cvy7/s_controller/hw/ev69_1_1.png

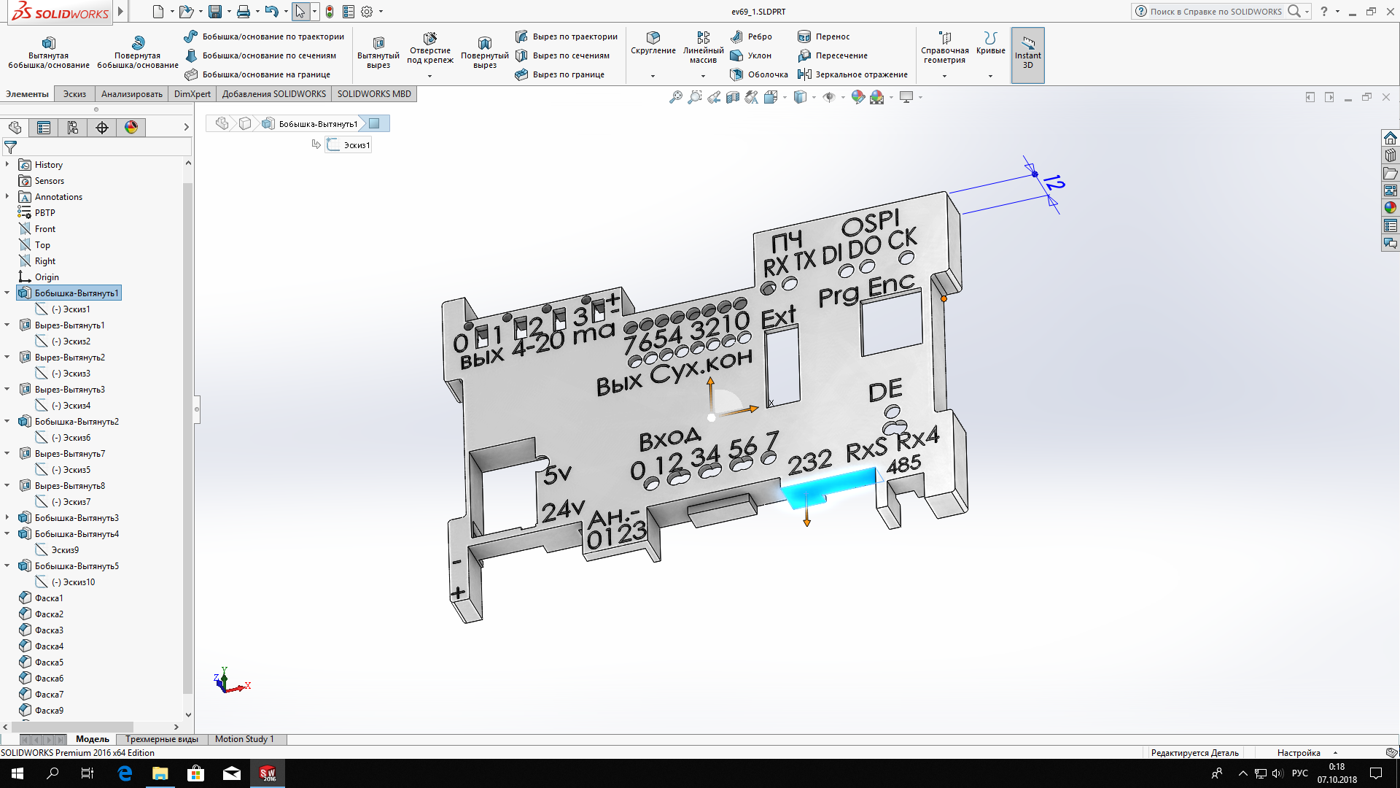
hw/ev69_1_1.png
