cvy7/s_controller/hw/ev69_1_2.png

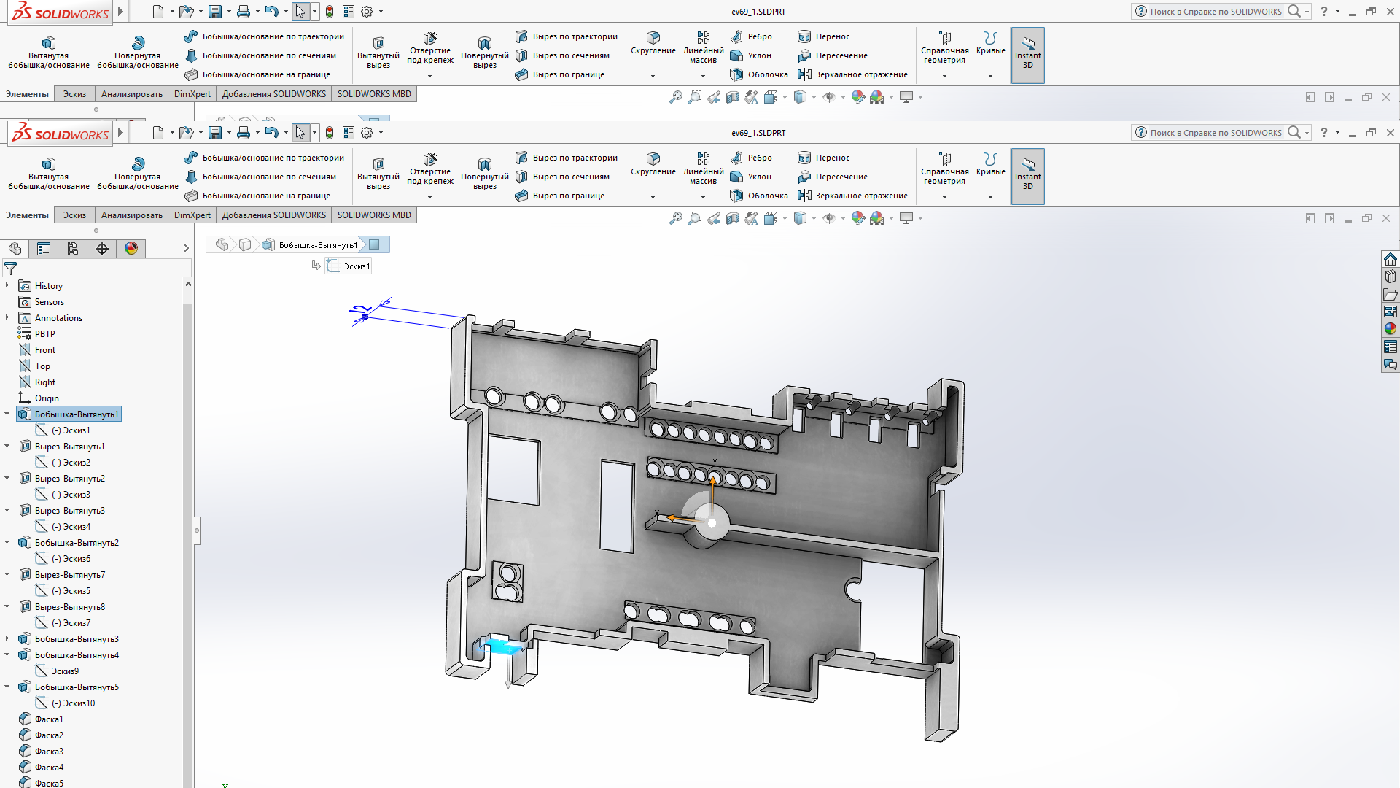
hw/ev69_1_2.png
