cvy7/s_controller/hw/ev69_2_1.png

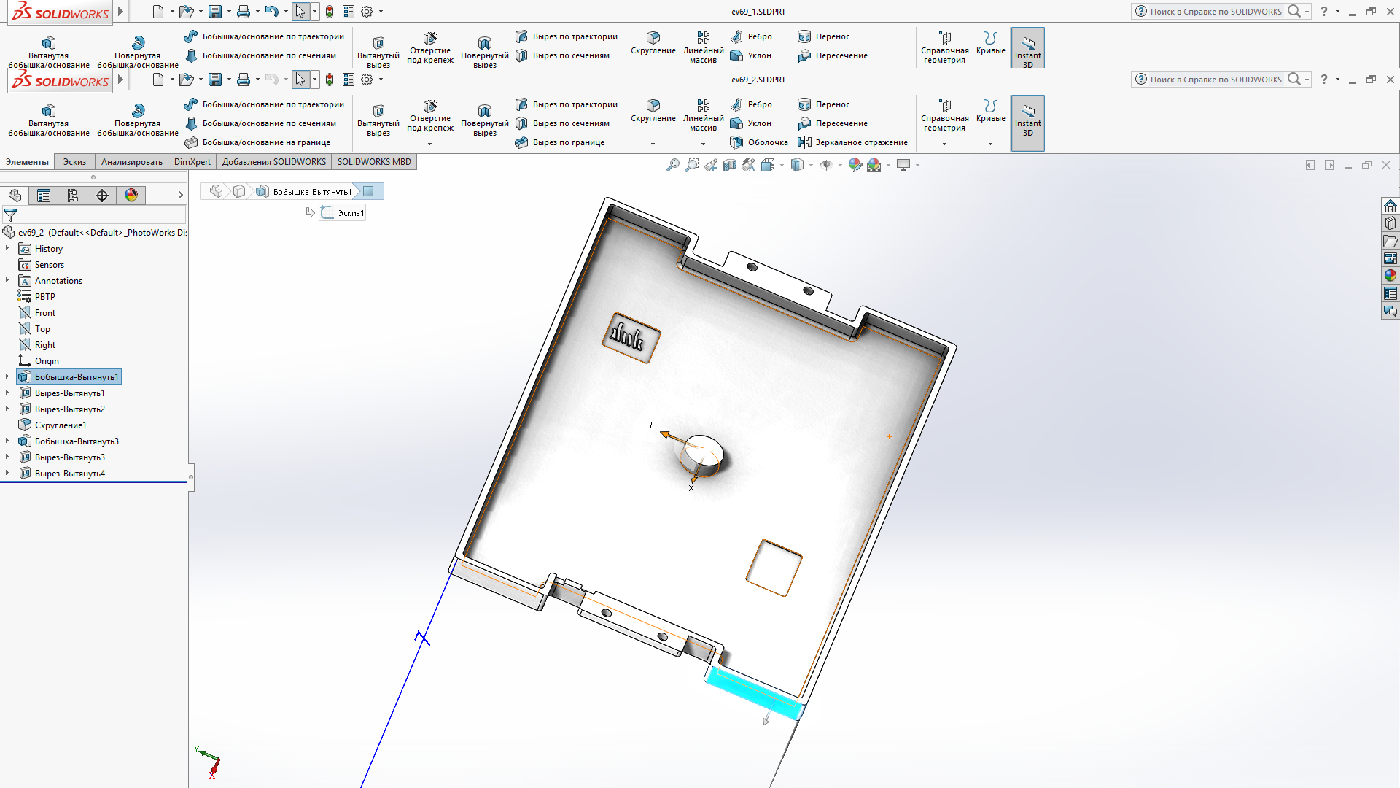
hw/ev69_2_1.png
