cvy7/s_controller/hw/ev69_2_2.png

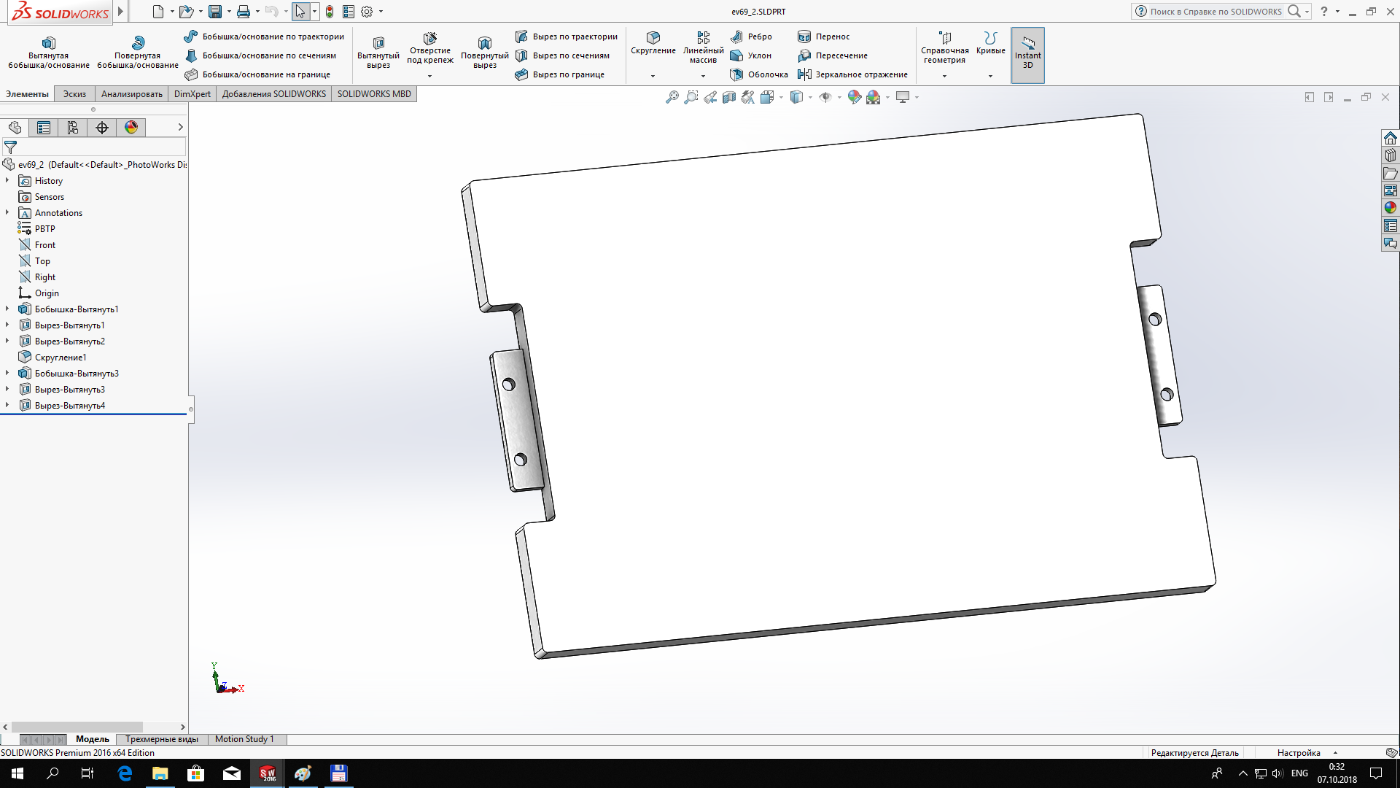
hw/ev69_2_2.png
