cvy7/s_controller/hw/ev69_00vp_pe_sp.ods

Sheet: ВП
№ строки | Наименование | Количество
 |  | на из- делие | в ком- плекты | на ре- гулир. | всего | S
 | Конденсаторы танталовые тип X,C,D,E
 | чип тант.35В 15мкФ 10% D | 2 |  |  | 4 | 8
 | чип тант.16В 47мкФ 20% D | 8 |  |  | 16 | 32
 | Чип-конденсаторы 0805
 | чип 0805 NP0 33pF ±5% 50V/ 33 пФ | 2 |  |  | 4 | 8
 | чип 0805 NP0 1000p ±10% 50V /1000 пФ | 6 |  |  | 12 | 20
 | чип 0805 NP0 1000p ±10% 50V /1000 пФ 01 | 4 |  |  | 8
 | чип 0805 X7R 0.01uF ±10% 100V / 0,01 мкФ | 4 |  |  | 8 | 8
 | чип 0805 X7R 0.1uF ±10% 100V/ 0,1 мкФ | 13 |  |  | 26 | 66
 | чип 0805 X7R 0.1uF ±10% 100V/ 0,1 мкФ 01 | 20 |  |  | 40
 | чип 0805 X7R 1uF ±10% 16V | 11 |  |  | 22 | 48
 | чип 0805 X7R 1uF ±10% 16V 01 | 13 |  |  | 26
 | DC/DC конверторы
 | AM1/4LS-0505S-NZ 01 | 3 |  |  | 6 | 10
 | AM1/4LS-0505S-NZ | 2 |  |  | 4
 | AM5T-2405SZ | 1 |  |  | 2 | 4
 | Микросхемы
 | DAC7571IDBVT | 2 |  |  | 4 | 8
 | MCP4725A0T-E/CH | 2 |  |  | 4 | 8
 | XTR115UA | 4 |  |  | 8 | 16
 | ISO1540D/ ISO1541D | 5 |  |  | 10 | 20
 | ISO3088DW | 1 |  |  | 2 | 4
 | SN74HC10D | 1 |  |  | 2 | 4
 | LF50CDT | 1 |  |  | 2 | 4
 | ATMEGA128A-AU | 1 |  |  | 2 | 4
 | ISO7221BD 01 | 1 |  |  | 2 | 4
 | ADM232AARNZ 01 | 1 |  |  | 2 | 4
 | ADS1114IDGST | 2 |  |  | 4 | 12
 | ADS1114IDGST 01 | 4 |  |  | 8
 | Оптопары
 | TLP627(F) | 6 |  |  | 12 | 24
 | TLP621(GB(F) | 2 |  |  | 4 | 8
 | HCPL2631 | 2 |  |  | 4 | 12
 | HCPL2631 01 | 4 |  |  | 8
 | Самовосст.предохр. LP60 - 375F | 1 |  |  | 2 | 4
 | Индикаторы KP1608
 | KP-1608SGC 01 | 38 |  |  | 76 | 138
 | KP-1608SGC | 31 |  |  | 62
 | Соединитель DBS-9M Z+H 01 | 1 |  |  | 2 | 2
 | (3-1634222-2)
 | Wiieland 8513 S/3 G+ 8513/3 BFK | 1 |  |  | 2 | 4
 | Wiieland 8113 S/8 GOF+ 8113/8 BFK | 4 |  |  | 8 | 16
 | Wiieland 8113 S/6 GOF+ 8113/6 BFK | 2 |  |  | 4 | 8
 | Wiieland 8113 S/5 GOF+ 8113/5 BFK | 1 |  |  | 2 | 4
 | Wiieland 8113 S/2 GOF+ 8113/2 BFK | 4 |  |  | 8 | 16
 | Резистор прецезионный С2-29-0,25 0,1%/ C2-29-0,5 0,1%/ ptf65 0,1%
 | 499 Ом 01 | 4 |  |  | 8 | 12
 | 499 Ом | 2 |  |  | 4
 | Резистор прецезионный
 | 0805/ 1206/ с2-29-0,125/ mf-0,125/ ptf51/ ptf56 0,1%
 | 29,1 кОм 0,1% | 6 |  |  | 12 | 28
 | 29,1 кОм 0,1% 01 | 8 |  |  | 16
 | 127 кОм 0,1% | 6 |  |  | 12 | 28
 | 127 кОм 0,1% 01 | 8 |  |  | 16
 | Чип-резисторы R0805
 | 0805 15 Ом | 16 |  |  | 32 | 64
 | 0805 47 Ом | 2 |  |  | 4 | 8
 | 0805 100 Ом | 3 |  |  | 6 | 12
 | 0805 100 Ом 01 | 5 |  |  | 10 | 20
 | 0805 240 Ом | 4 |  |  | 8 | 24
 | 0805 240 Ом 01 | 8 |  |  | 16
 | 0805 330 Ом | 2 |  |  | 4 | 12
 | 0805 330 Ом 01 | 4 |  |  | 8
 | 0805 510 Ом | 20 |  |  | 40 | 86
 | 0805 510 Ом 01 | 23 |  |  | 46
 | 0805 1,2 кОм | 19 |  |  | 38 | 100
 | 0805 1,2 кОм 01 | 31 |  |  | 62
 | 0805 2,4 кОм | 16 |  |  | 32 | 72
 | 0805 2,4 кОм 01 | 20 |  |  | 40
 | 0805 10 кОм | 10 |  |  | 20 | 40
 | 0805 33 кОм | 12 |  |  | 24 | 48
 | YC164-FR-072K4L, Резисторная сборка | 4 |  |  | 8 | 16
 | SMD 1206 4 резисторов по 2.4кОм
 | Резонатор кварцевый HC49/S 18.432 МГц | 1 |  |  | 2 | 4
 | (18432kHz 20ppm 20 pF)
 | Диод | 1 |  |  | 2 | 4
 | MBRS340T3 | 1 |  |  | 2 | 4
 | US1G | 4 |  |  | 8 | 16
 | Суппрессор 1,5SMC43A | 1 |  |  | 2 | 4
 | Суппрессор SMAJ30A-TR | 12 |  |  | 24 | 48
 | Стабилитроны
 | BZT52H-C5V6 | 4 |  |  | 8 | 26
 | BZT52H-C5V6 01 | 9 |  |  | 18
 | Транзисторы
 | bss138 | 1 |  |  | 2 | 8
 | bss138 01 | 3 |  |  | 6
 | BD137-16 | 4 |  |  | 8 | 16
 |  |  |  |  | 0 | 0
 | Оптопередатчики |  |  |  | 0 | 0
 | HFBR-1528 | 1 |  |  | 2 | 8
 | HFBR-1528 01 | 3 |  |  | 6
 | Оптоприемники
 | HFBR-2521 | 1 |  |  | 2 | 6
 | HFBR-2521 01 | 2 |  |  | 4
 | Вилки
 | IDC16M | 1 |  |  | 2 | 4
 | IDC10M | 2 |  |  | 4 | 8
 | Монтажный адаптер
 | для серий 261/262
 | (rubilnik.ru)(wago 209-123) | 2 |  |  | 4 | 8

Sheet: PE4
Поз. обозна- чение | Наименование | Кол. | Примечание
 | Чип-конденсаторы 0805
 | Конденсаторы танталовые тип X,C,D,E
C1 | чип 0805 X7R 1uF ±10% 16V/ 1 мкФ | 1
C2...C5 | чип 0805 NP0 1000p ±10% 50V /1000 пФ | 4
C6...C9 | чип 0805 NP0 1000p ±10% 50V /1000 пФ 01 | 4
C10 | чип 0805 X7R 0.1uF ±10% 100V | 1
C11 | чип 0805 NP0 33pF ±5% 50V/ 33 пФ | 1
C12 | чип 0805 X7R 1uF ±10% 16V/ 1 мкФ | 1
C13 | чип 0805 NP0 33pF ±5% 50V/ 33 пФ | 1
C14,C15 | чип 0805 X7R 1uF ±10% 16V/ 1 мкФ | 2
C16...C18 | чип 0805 X7R 0.1uF ±10% 100V / 0,1 мкФ | 3
C19 | чип 0805 X7R 1uF ±10% 16V/ 1 мкФ | 1
C20,C21 | чип 0805 NP0 1000p ±10% 50V /1000 пФ | 2
C29...C33 | чип 0805 X7R 0.1uF ±10% 100V / 0,1 мкФ 01 | 5
C46,C47 | чип тант.35В 15мкФ 10% D | 2
C48...C55 | чип тант.16В 47мкФ 20% D | 8
C65,C66 | чип 0805 X7R 1uF ±10% 16V/ 1 мкФ 01 | 2
C67 | чип 0805 X7R 1uF ±10% 16V/ 1 мкФ | 1
C68 | чип 0805 X7R 0.1uF ±10% 100V | 1
C69,C70 | чип 0805 X7R 1uF ±10% 16V/ 1 мкФ | 2
C71 | чип 0805 X7R 0.1uF ±10% 100V | 1
C72 | чип 0805 X7R 1uF ±10% 16V/ 1 мкФ | 1
C73 | чип 0805 X7R 0.1uF ±10% 100V | 1
C74,C75 | чип 0805 X7R 1uF ±10% 16V/ 1 мкФ | 2
C76,C77 | чип 0805 X7R 1uF ±10% 16V/ 1 мкФ 01 | 2
C78 | чип 0805 X7R 0.01uF ±10% 100V / 0,01 мкФ | 1
C79 | чип 0805 X7R 0.1uF ±10% 100V / 0,1 мкФ | 1
C80 | чип 0805 X7R 0.01uF ±10% 100V / 0,01 мкФ | 1
C81 | чип 0805 X7R 0.1uF ±10% 100V / 0,1 мкФ | 1
C82 | чип 0805 X7R 0.01uF ±10% 100V / 0,01 мкФ | 1
C83 | чип 0805 X7R 0.1uF ±10% 100V / 0,1 мкФ | 1
C84 | чип 0805 X7R 0.01uF ±10% 100V / 0,01 мкФ | 1
C85...C87 | чип 0805 X7R 0.1uF ±10% 100V / 0,1 мкФ | 3
C88,C89 | чип 0805 X7R 0.1uF ±10% 100V / 0,1 мкФ 01 | 2
 | Оптопары
 | Микросхемы
DA1,DA2 | TLP627 | 2
DA3,DA4 | TLP621 | 2
DA5 | DAC7571IDBVT | 1
DA6...DA9 | TLP627 | 4
DA10 | DAC7571IDBVT | 1
DA11,DA12 | MCP4725A0T - E | 2
DA13 | LF50CDT | 1
DA17 | DC/DC AM5T-2405SZ | 1
DA19...DA22 | XTR115U | 4
DA27...DA31 | ISO1540BD | 5
DA44 | DC/DC AM1/4L-0505NZ 01 | 1
DA45,DA49 | DC/DC AM1/4L-0505NZ | 2
U1,U2 | ads1114idgst | 2
U3,U4 | ads1114idgst 01 | 2
DD1 | ATMEGA128AU | 1
DD2 | ADM232AARN 01 | 1
DD3 | ISO7221D 01 | 1
DD4 | ISO3088DW | 1
DD6 | SN74HC10D | 1
FU1 | Самовосст.предохр. LP60 - 375F | 1
 | Светодиоды
HL3...HL6 | KP-1608SGC | 4
HL7...HL10 | KP-1608SGC 01 | 4
HL27...HL46, | KP-1608SGC | 26
HL71,HL72,
HL75...HL78
HL79...HL81 | KP-1608SGC 01 | 3
HL82 | KP-1608SGC | 1
 | Чип-резисторы
 | Резисторы точные
R1 | 0805 10 кОм | 1
R3...R6 | 0805 1,2 кОм | 4
R7...R9 | 0805 1,2 кОм 01 | 3
R11...R14 | 0805 1,2 кОм | 4
R15...R17 | 0805 1,2 кОм 01 | 3
R18...R21 | 0805 2,4 кОм | 4
R22...R25 | 0805 2,4 кОм 01 | 4
R26 | 0805 1,2 кОм 01 | 1
R27 | 0805 2,4 кОм | 1
R29 | 0805 240 Ом | 1
R30,R31 | 0805 1,2 кОм | 2
R32,R33 | 0805 240 Ом | 2
R34 | 0805 1,2 кОм | 1
R35 | 0805 240 Ом | 1
R36 | 0805 1,2 кОм | 1
R37 | 0805 240 Ом 01 | 1
R38 | 0805 1,2 кОм 01 | 1
R39 | 0805 240 Ом 01 | 1
R40 | 0805 1,2 кОм 01 | 1
R41 | 0805 240 Ом 01 | 1
R42 | 0805 1,2 кОм 01 | 1
R43 | 0805 240 Ом 01 | 1
R44,R45 | 0805 1,2 кОм 01 | 2
R49...R51 | 0805 2,4 кОм | 3
R147,R148 | 0805 330 Ом 01 | 2
R149...R164 | 0805 15 Ом | 16
R165...R172 | 0805 33 кОм | 8
R173...R188 | 0805 510 Ом | 16
R189 | 0805 127 кОм | 1
R190 | 0805 29,1 кОм 0,1% | 1
R191,R192 | 0805 10 кОм | 2
R193 | 0805 33 кОм | 1
R194 | 0805 127 кОм | 1
R195 | 0805 29,1 кОм 0,1% | 1
R196,R197 | 0805 10 кОм | 2
R198 | 0805 33 кОм | 1
R199 | 0805 127 кОм | 1
R200 | 0805 29,1 кОм 0,1% | 1
R201,R202 | 0805 10 кОм | 2
R203 | 0805 33 кОм | 1
R204 | 0805 127 кОм | 1
R205 | 0805 29,1 кОм 0,1% | 1
R206,R207 | 0805 10 кОм | 2
R208 | 0805 33 кОм | 1
R209,R210 | 0805 1,2 кОм | 2
R253 | 0805 10 кОм | 1
R254 | 0805 510 Ом | 1
R275 | 0805 2,4 кОм | 1
R276 | 0805 47 Ом | 1
R277 | 0805 2,4 кОм | 1
R278 | 0805 47 Ом | 1
R279 | 0805 330 Ом | 1
R280...R282 | 0805 100 Ом | 3
R283 | 0805 1,2 кОм | 1
R284 | 0805 2,4 кОм | 1
R285,R286 | 0805 510 Ом | 2
R287,R288 | C2-29_0.25W 499 Ом | 2
R289...R292 | 0805 2,4 кОм | 4
R293,R294 | C2-29_0.25W 499 Ом 01 | 2
R295,R296 | 0805 29,1 кОм 0,1% | 2
R297,R298 | 0805 127 кОм 0,1% | 2
R299 | 0805 1,2 кОм | 1
R300 | 0805 127 кОм 0,1% 01 | 1
R301 | 0805 29,1 кОм 0,1% 01 | 1
R302 | 0805 127 кОм 0,1% 01 | 1
R303 | 0805 29,1 кОм 0,1% 01 | 1
R304 | 0805 1,2 кОм | 1
R305 | 0805 100 Ом 01 | 1
R306,R307 | 0805 510 Ом 01 | 2
R308,R309 | 0805 100 Ом 01 | 2
R310 | 0805 510 Ом | 1
R311 | 0805 2,4 кОм | 1
R312 | 0805 510 Ом 01 | 1
R313,R314 | 0805 100 Ом 01 | 2
R315,R316 | 0805 1,2 кОм | 2
R318 | 0805 330 Ом | 1
RP20...RP23 | Резисторная сборка YC164-FR-072K4L 2,4 кОм | 4
SQ1 | Резонатор кварцевый _ HC49/S 18.432 МГц | 1
 | Суппрессоры
 | Стабилитроны
 | Диоды
VD2...VD5 | BZT52H-C5V6 | 4
VD6...VD9 | BZT52H-C5V6 01 | 4
VD26...VD37 | SMAJ30A | 12
VD50 | MBRS340T3 | 1
VD51 | 1,5smc43a | 1
VD64 | BZT52H-C5V6 01 | 1
VD65...VD68 | US1G | 4
 | Транзисторы
VT2 | BSS138 | 1
VT3,VT4 | BSS138 01 | 2
VT12...VT15 | BD137-16 | 4
 | Оптопары
VU3,VU4 | HCPL2631 | 2
VU5,VU6 | HCPL2631 01 | 2
 | Оптоприемники HFBR-2528
 | Оптопередатчики HFBR-1528
VU19 | HFBR-2521 | 1
VU20 | HFBR-1528 | 1
VU21 | HFBR-1528 01 | 1
VU22 | HFBR-2521 01 | 1
VU23 | HFBR-1528 01 | 1
 | Вилки
XP1,XP2 | IDC10M | 2
XP3 | IDC16M | 1
 | Соединители
X1..X4 | Wieland 8113 S/2 GOF+ 8113/2 BFK | 4+4
X5 | Wieland 8113 S/8 GOF+ 8113/8 BFK | 2+2
X11 | Wieland 8113 S/6 GOF+ 8113/6 BFK | 2+2
X12 | Wieland 8113 S/5 GOF+ 8113/5 BFK | 1+1
X13 | Wieland 8113 S/8 GOF+ 8113/8 BFK | 2+2
X14 | DB9M DBS - 9M Z+H | 1
X15 | Wieland 8513 S/3 G+ 8513/3 BFK | 1+1
X16,X17 | Монтажный адаптер для серий 261/262 (rubilnik.ru)(wago 209-123) | 2

Sheet: SP
Формат | Зона | Поз. | Наименование | Кол. | Приме- чание
 |  |  | Прочие изделия
 |  |  | Конденсаторы танталовые тип D
 |  |  | чип тант.35В 15мкФ 10% D | 2 | C46,C47
 |  |  | чип тант.16В 47мкФ 20% D | 8 | C48...C55
 |  |  | Чип-конденсаторы 0805
 |  |  | чип 0805 NP0 33pF ±5% 50V/ 33 пФ | 2 | C11,C13
 |  |  | чип 0805 NP0 1000p ±10% 50V /1000 пФ | 6 | C2...C5,
 |  |  |  |  | C20,C21
 |  |  | чип 0805 NP0 1000p ±10% 50V /1000 пФ 01 | 4 | C6..С9
 |  |  | чип 0805 X7R 0.01uF ±10% 50V / 0,01 мкФ | 4 | С78,С80,
 |  |  |  |  | С82,С82
 |  |  | чип 0805 X7R 0.1uF ±10% 100V / 0,1 мкФ | 13 | C10,
 |  |  |  |  | C16...C18
 |  |  |  |  | C68,C71,
 |  |  |  |  | C73,C79,
 |  |  |  |  | C81,C83,
 |  |  |  |  | C85...C87,
 |  |  | чип 0805 X7R 0.1uF ±10% 100V / 0,1 мкФ 01 | 7 | C29...C33
 |  |  |  |  | C88,C89
 |  |  | чип 0805 X7R 1uF ±10% 16V/ 1 мкФ | 11 | C1,C12,
 |  |  |  |  | C14,C15,
 |  |  |  |  | C19
 |  |  |  |  | C67,C69,
 |  |  |  |  | C70,C72,
 |  |  |  |  | C74,C75
 |  |  | чип 0805 X7R 1uF ±10% 16V/ 1 мкФ 01 | 4 | C65,C66
 |  |  |  |  | C76,C77
 |  |  | Микросхемы
 |  |  | AM1/4L-0505NZ 01 | 1 | DA44
 |  |  | AM1/4L-0505NZ | 2 | DA45,DA49
 |  |  | DAC7571IDBVT | 2 | DA5,DA10
 |  |  | MCP4725A0T - E | 2 | DA11,DA12
 |  |  | AM5T-2405SZ | 1 | DA17
 |  |  | LF50CDT | 1 | DA13
 |  |  | XTR115U | 4 | DA19...DA22
 |  |  | ISO1540BD | 5 | DA27...DA31
 |  |  | ads1114idgst | 2 | U1,U2
 |  |  | ads1114idgst 01 | 2 | U3,U4
 |  |  | Оптопары
 |  |  | TLP621 | 2 | DA3,DA4
 |  |  | TLP627 | 6 | DA1,DA2
 |  |  |  |  | DA6...DA9
 |  |  | HCPL2631 | 2 | VU3,VU4
 |  |  | HCPL2631 01 | 2 | VU5,VU6
 |  |  | Микросхемы
 |  |  | ATMEGA128AU | 1 | DD1
 |  |  | ADM232AARN 01 | 1 | DD2
 |  |  | Iso7221bd 01 | 1 | DD3
 |  |  | ISO3088DW | 1 | DD4
 |  |  | SN74HC10D | 1 | DD6
 |  |  | Самовосст.предохр. _ LP60 - 375F | 1 | FU1
 |  |  | Светодиоды
 |  |  | KP-1608SGC | 31 | HL3...HL6,
 |  |  |  |  | HL27...HL46,
 |  |  |  |  | HL71,HL72,
 |  |  |  |  | HL75...HL78
 |  |  |  |  | HL82
 |  |  | KP-1608SGC 01 | 7 | HL7...HL10
 |  |  |  |  | HL79...HL81
 |  |  | Соединитель DB9M DBS - 9M Z+H | 1 | HS1
 |  |  | Резистор C2-29_0.25W 499 Ом | 2 | R287,R288
 |  |  | Резистор C2-29_0.25W 499 Ом 01 | 2 | R293,R294
 |  |  | Чип-резисторы 0805
 |  |  | 0805 15 Ом | 16 | R149...R164
 |  |  | 0805 47 Ом | 2 | R276,R278
 |  |  | 0805 100 Ом | 3 | R280...R282
 |  |  | 0805 100 Ом 01 | 5 | R305,R308,
 |  |  |  |  | R309,R313,
 |  |  |  |  | R314
 |  |  | 0805 240 Ом | 4 | R29,R32,
 |  |  |  |  | R33,R35
 |  |  | 0805 240 Ом 01 | 4 | R37,R39,
 |  |  |  |  | R41,R43
 |  |  | 0805 330 Ом | 2 | R279,R318
 |  |  | 0805 330 Ом 01 | 2 | R147,R148
 |  |  | 0805 510 Ом | 20 | R173...R188,
 |  |  |  |  | R254,R285,
 |  |  |  |  | R286,R310
 |  |  | 0805 510 Ом 01 | 3 | R306,R307
 |  |  |  |  | R312
 |  |  | 0805 1,2 кОм | 19 | R3...R6,
 |  |  |  |  | R11..R14,
 |  |  |  |  | R30...R31,
 |  |  |  |  | R34,R36,
 |  |  |  |  | R209,R210,
 |  |  |  |  | R283,R299,
 |  |  |  |  | R304,R315,
 |  |  |  |  | R316
 |  |  | 0805 1,2 кОм 01 | 16 | R7...R9,
 |  |  |  |  | R15...R17,
 |  |  |  |  | R22...R25,
 |  |  |  |  | R26,R38,
 |  |  |  |  | R40,R42,
 |  |  |  |  | R44,R45
 |  |  | 0805 2,4 кОм | 16 | R18..R21,
 |  |  |  |  | R27,
 |  |  |  |  | R49...R51,
 |  |  |  |  | R275,R277,
 |  |  |  |  | R284,
 |  |  |  |  | R289..R292,
 |  |  |  |  | R311
 |  |  | 0805 2,4 кОм 01 | 4 | R22...R25
 |  |  | R0805 10 кОм | 10 | R1,R191,
 |  |  |  |  | R192,R196,
 |  |  |  |  | R197,R201,
 |  |  |  |  | R202,R206,
 |  |  |  |  | R207,R253
 |  |  | 0805 29,1 кОм | 6 | R190,R195,
 |  |  |  |  | R200,R205,
 |  |  |  |  | R295,R296
 |  |  | 0805 29,1 кОм 01 | 2 | R301,R303
 |  |  | 0805 33 кОм | 12 | R165...R172,
 |  |  |  |  | R193,R198,
 |  |  |  |  | R203,R208
 |  |  | 0805 127 кОм 0,1% | 6 | R189,R194,
 |  |  |  |  | R199,R204,
 |  |  |  |  | R297,R298
 |  |  | 0805 127 кОм 0,1% 01 | 2 | R300,R302
 |  |  | Резисторная сборка YC164-FR-072K4L 2,4 кОм | 4 | RP20...RP23
 |  |  | Резонатор кварцевый _ HC49/S 18.432 Мгц | 1 | SQ1
 |  |  | Диоды
 |  |  | MBRS340T3 | 1 | VD50
 |  |  | us1g | 4 | VD65...VD68
 |  |  | Суппрессор 1,5smc43a | 1 | VD51
 |  |  | Стабилитроны
 |  |  | ZZM - 55c - 5v6 | 4 | VD2...VD5
 |  |  | ZZM - 55c - 5v6 01 | 5 | VD6...VD9,
 |  |  |  |  | VD64
 |  |  | Суппрессор SMAJ48A | 12 | VD26...VD37
 |  |  | Транзисторы
 |  |  | bss138 | 1 | VT2
 |  |  | bss138 01 | 2 | VT3,VT4
 |  |  | Транзистор BD137 - 16 | 4 | VT12...VT15
 |  |  | Оптопередатчики
 |  |  | HFBR-1528 | 1 | VU20
 |  |  | HFBR-1528 01 | 2 | VU21,VU23
 |  |  | Оптоприемники
 |  |  | HFBR-2521 | 1 | VU19
 |  |  | HFBR-2521 01 | 1 | VU22
 |  |  | Вилки
 |  |  | IDC10M | 2 | XP1,XP2
 |  |  | IDC16M | 1 | XP3
 |  |  | Соединители
 |  |  | Wieland 8113 S/2 GOF+ 8113/2 BFK | 4+4 | X1..X4
 |  |  | Wieland 8113 S/5 GOF+ 8113/5 BFK | 1+1 | X12
 |  |  | Wieland 8113 S/6 GOF+ 8113/6 BFK | 2+2 | X11
 |  |  | Wieland 8113 S/8 GOF+ 8113/8 BFK | 4+4 | X5,X13
 |  |  | Wieland 8513 S/3 G+ 8513/3 BFK | 1+1 | X15
 |  |  | Монтажный адаптер для серий 261/262 (wago 209-123)
 |  |  |  | 2 | X16,X17
