cvy7/s_controller/hw/ev69_2.SLDPRT

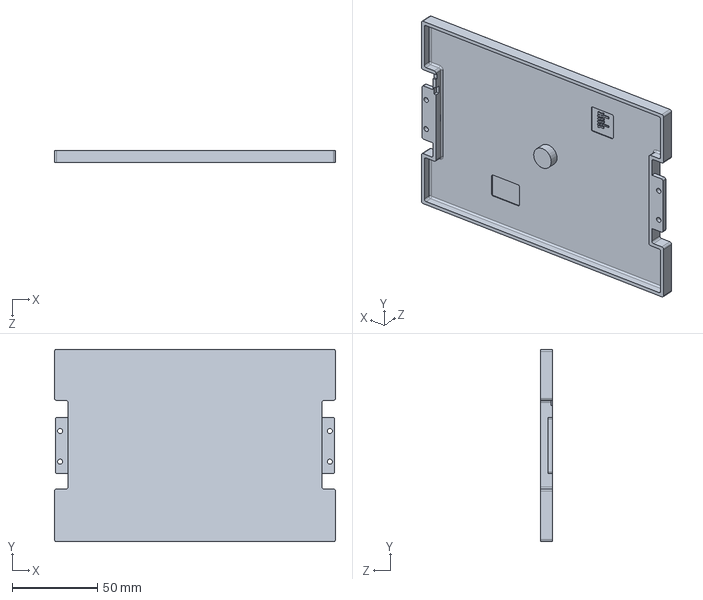
[picture p5: CAD file, 2018-10-07]
hw/ev69_2.SLDPRT
165.0 x 113.0 x 7.00 mm
