cvy7/s_controller/hw/ev69_1.SLDPRT

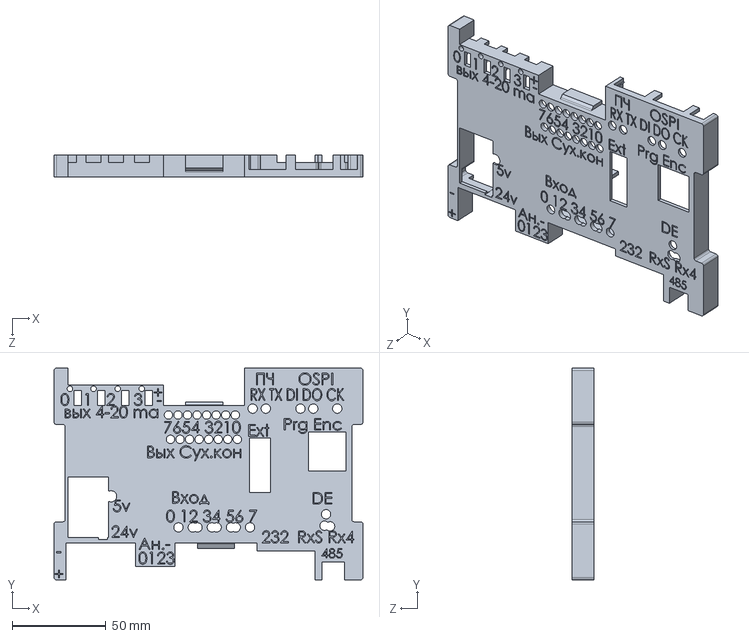
[picture p6: CAD file, 2018-10-07]
hw/ev69_1.SLDPRT
165.0 x 113.0 x 12.0 mm
