cvy7/s_controller/(list of files, cad)

Other CAD files:
hw/ev69_1.STL
hw/ev69_2.STL
