cvy7/s_controller/hw/ev69_00_e4.pdf

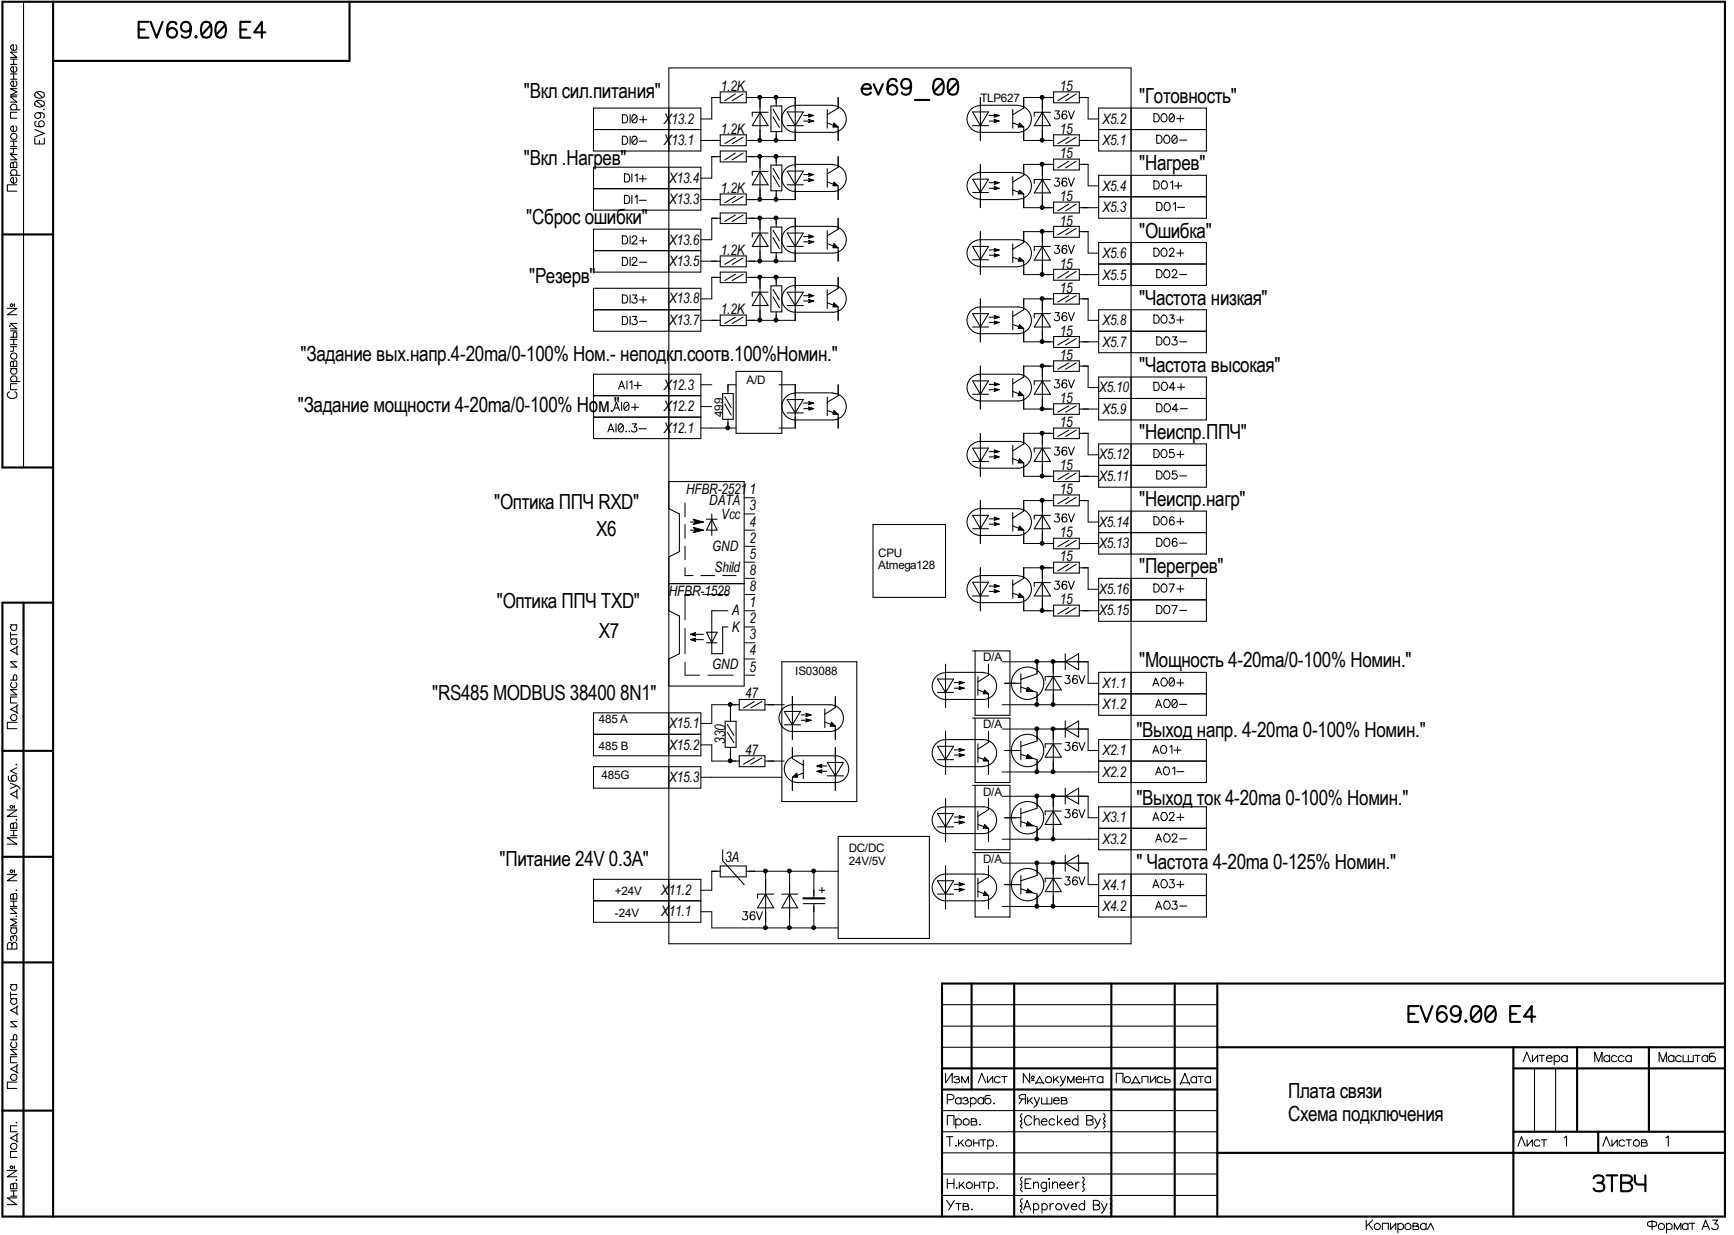
[picture p7: page 1]
CPU Atmega128; TLP627; "RS485 MODBUS 38400 8N1"; "Неиспр.нагр"; "Неиспр.ППЧ"; "Питание 24V 0.3A"; "Резерв"; "Сброс ошибки"; "Вкл .Нагрев"; "Перегрев"; "Частота низкая"; "Нагрев"; "Готовность" ¹⁵; GND; HFBR-1528; 3 Vcc; Shild; 2 GND; DATA; HFBR-2521; "Частота высокая"; "Ошибка"; "Мощность 4-20ma/0-100% Номин."; Плата связи Схема подключения; " Частота 4-20ma 0-125% Номин."

"Вкл сил.питания"

"Задание вых.напр.4-20ma/0-100% Ном.- неподкл.соотв.100%Номин."

"Задание мощности 4-20ma/0-100% Ном."

"Оптика ППЧ RXD"

"Оптика ППЧ TXD"

"Выход напр. 4-20ma 0-100% Номин."

"Выход ток 4-20ma 0-100% Номин."
