cvy7/s_controller/hw/ev69_00_top.pdf

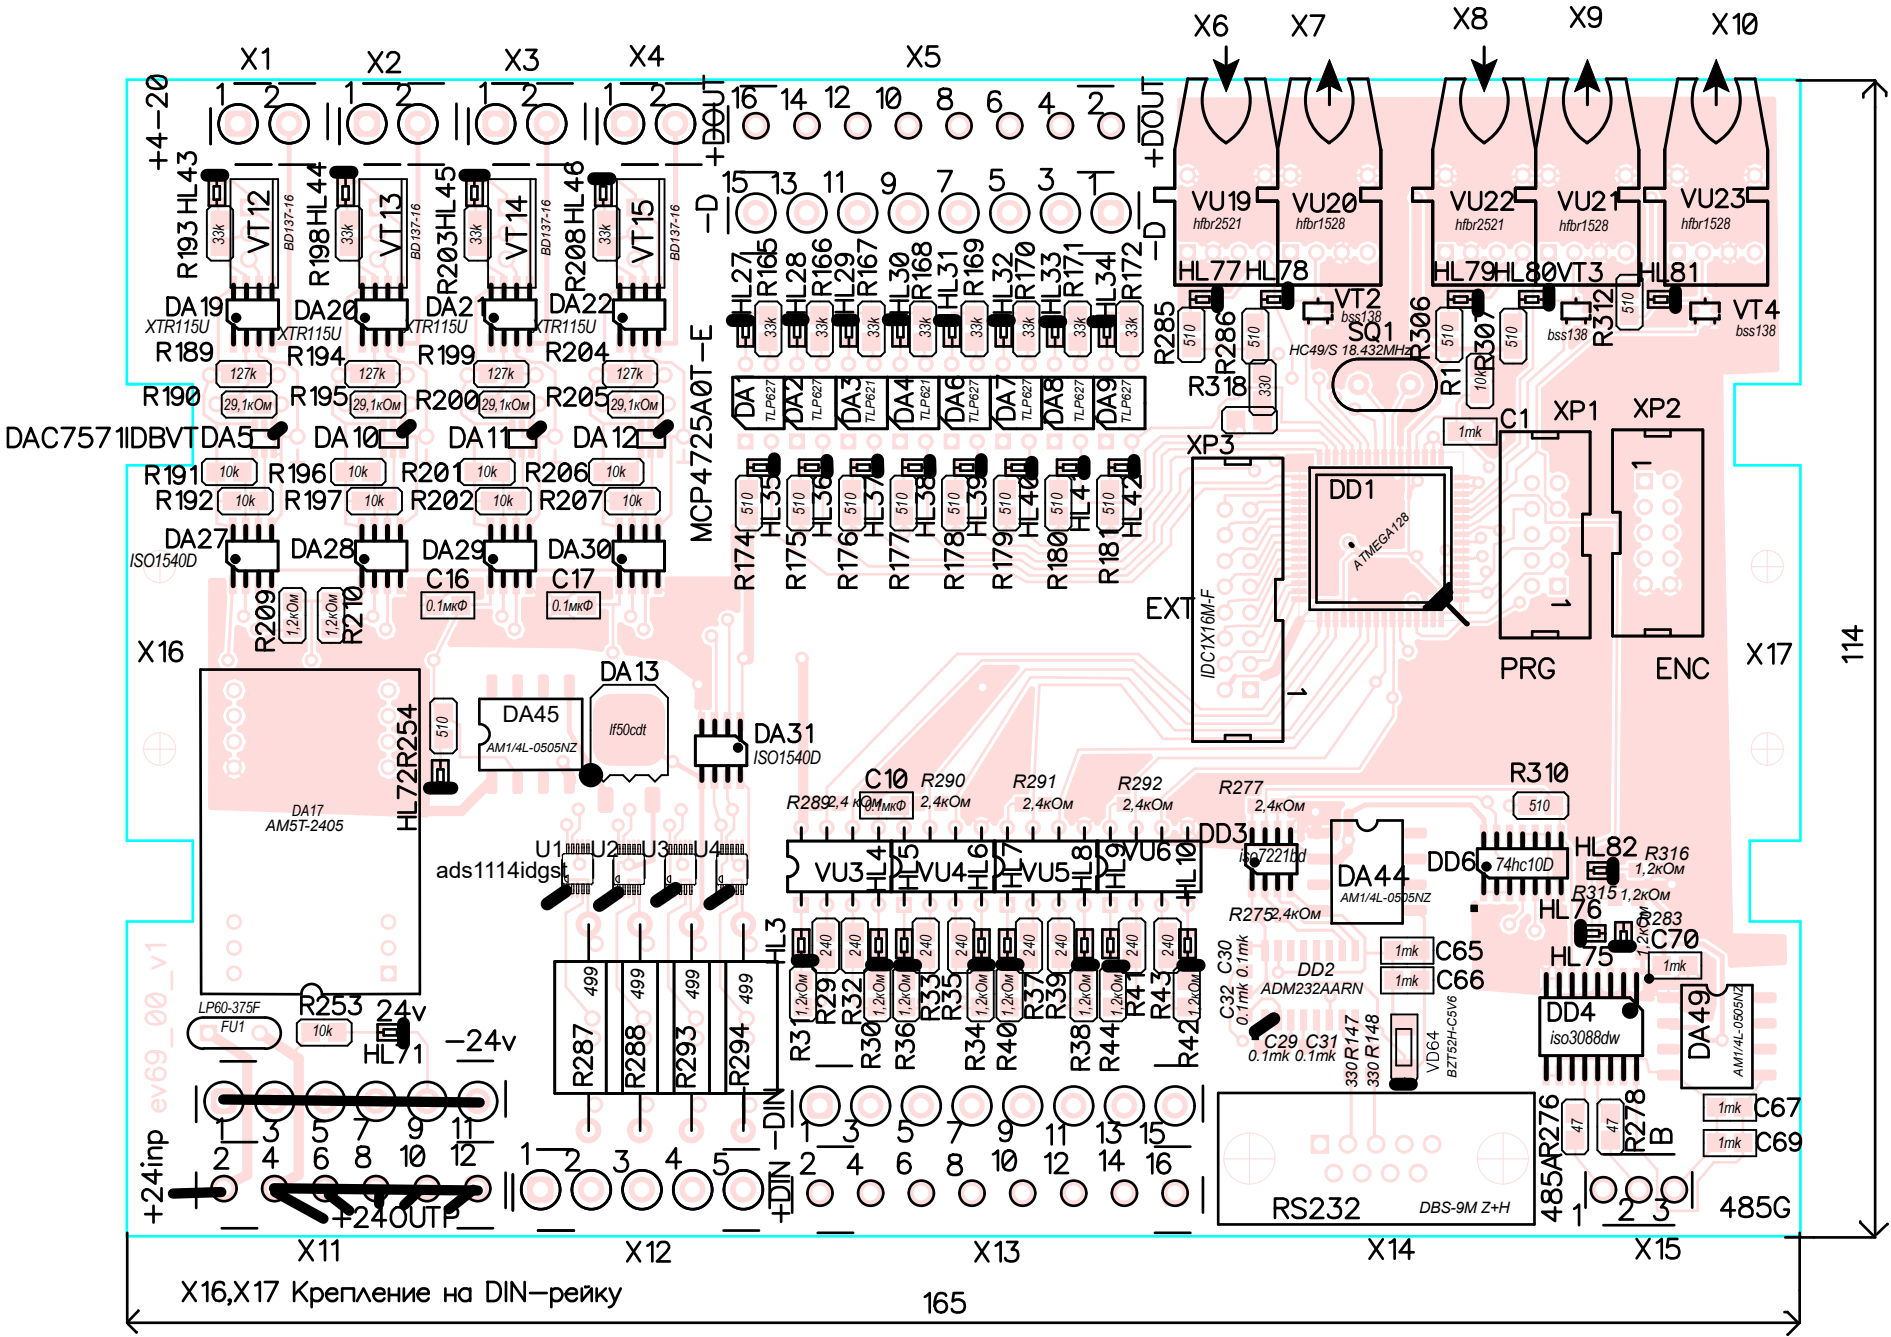
[picture p8: page 1]
