cvy7/s_controller/(list of files, drawings)

Other design files:
hw/ev69_00_v1_1.PCB
