cvy7/s_controller/config.h

#ifndef CONFIG_H
#define CONFIG_H

#define TPCH (1)
//#define PPCH (1)
//#define EMUL (1)

#include "conv_p18000_u1800_f500.h"
//#include "conv_p1600_u650_f2400.h"
#include "kalibr_3.h"
//#include "kalibr_2.h"
//#include "kalibr_1.h"

#endif // CONFIG_H
