cvy7/s_controller/mb_regs.h

#ifndef MB_REGS_H
#define MB_REGS_H
#define REG_INPUT_NREGS         (32)
#define REG_HOLDING_NREGS       (32)
extern unsigned short usRegInputBuf[REG_INPUT_NREGS];
extern unsigned short usRegHoldingBuf[REG_HOLDING_NREGS];
#endif // MB_REGS_H
